acacio90/curupira-diy/3d/kicad/LEIA-ME.md

# Modelos 3D da biblioteca padrão do KiCad

Cópias dos modelos usados na placa, para o projeto abrir completo mesmo sem a
biblioteca 3D do KiCad instalada. Fonte: https://gitlab.com/kicad/libraries/kicad-packages3d

Licença: CC-BY-SA 4.0 com a exceção das bibliotecas do KiCad
(https://www.kicad.org/libraries/license/) — o uso em projetos de placa é livre.
