acacio90/curupira-diy/arte/curupira_rosto.png

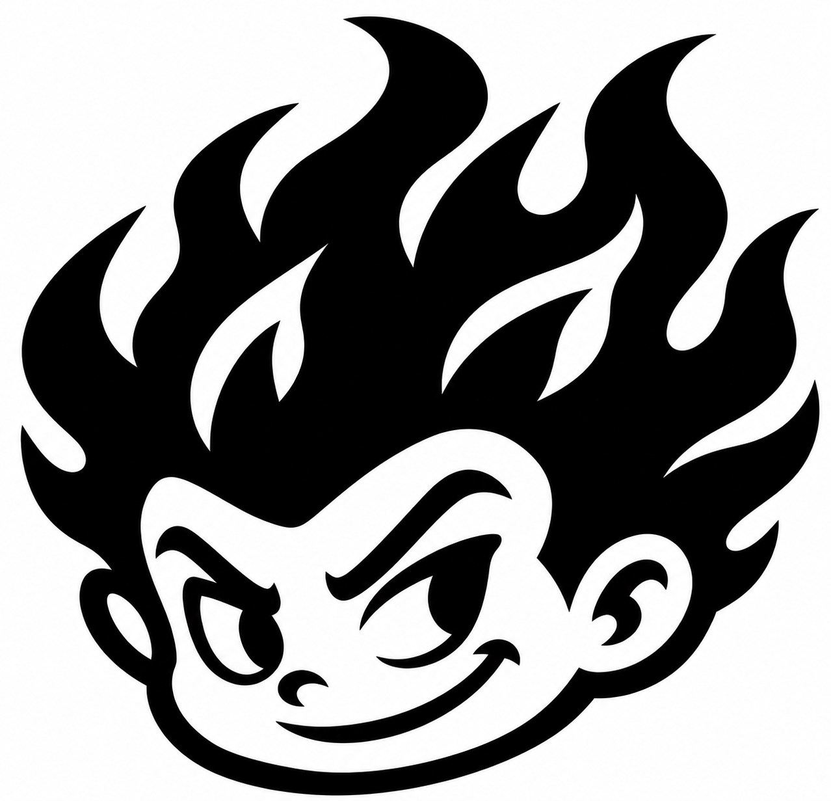
arte/curupira_rosto.png
