acacio90/curupira-diy/arte/curupira_rosto_branco.png

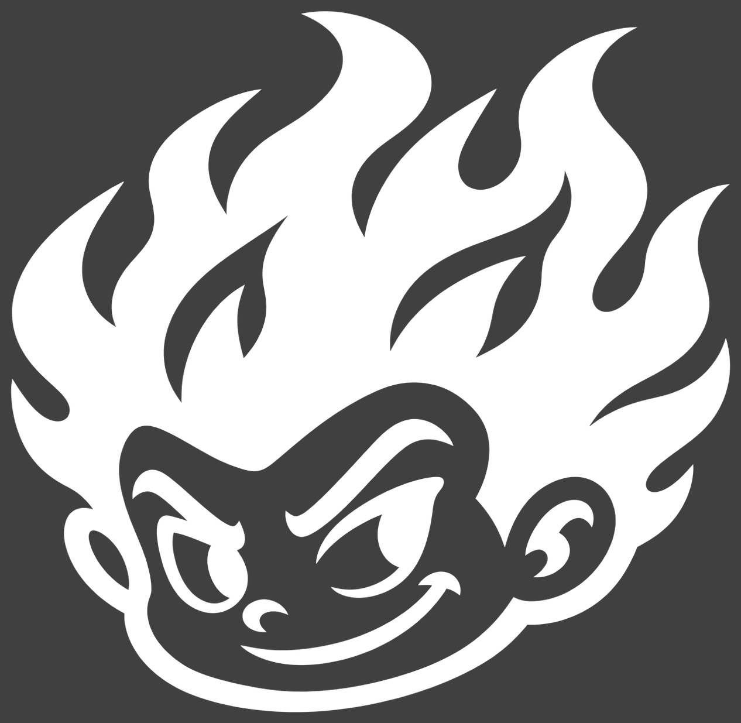
arte/curupira_rosto_branco.png
