acacio90/curupira-diy/arte/curupira_verso_pcb.png

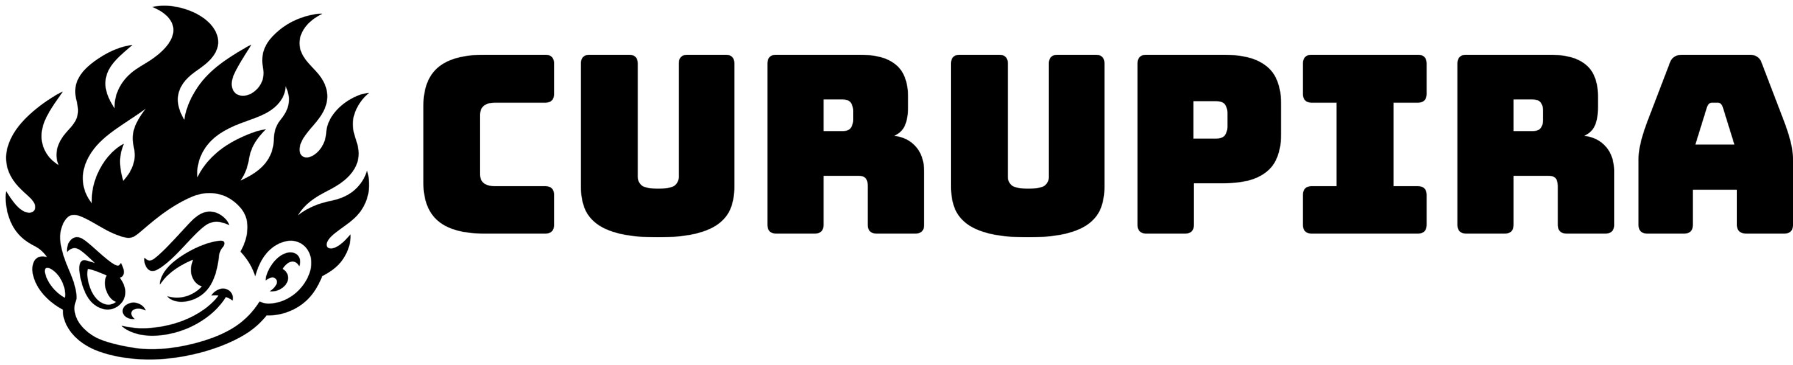
arte/curupira_verso_pcb.png
