acacio90/curupira-diy/renders/2d-frente.png

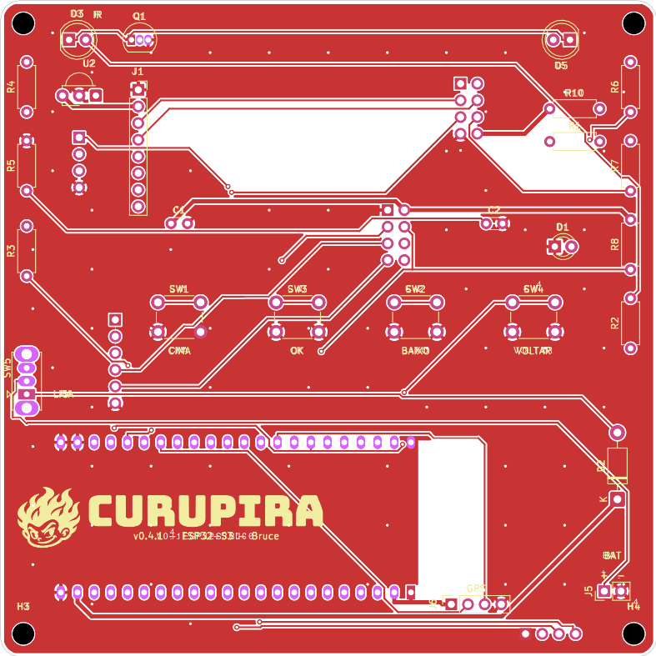
renders/2d-frente.png
