acacio90/curupira-diy/renders/2d-verso.png

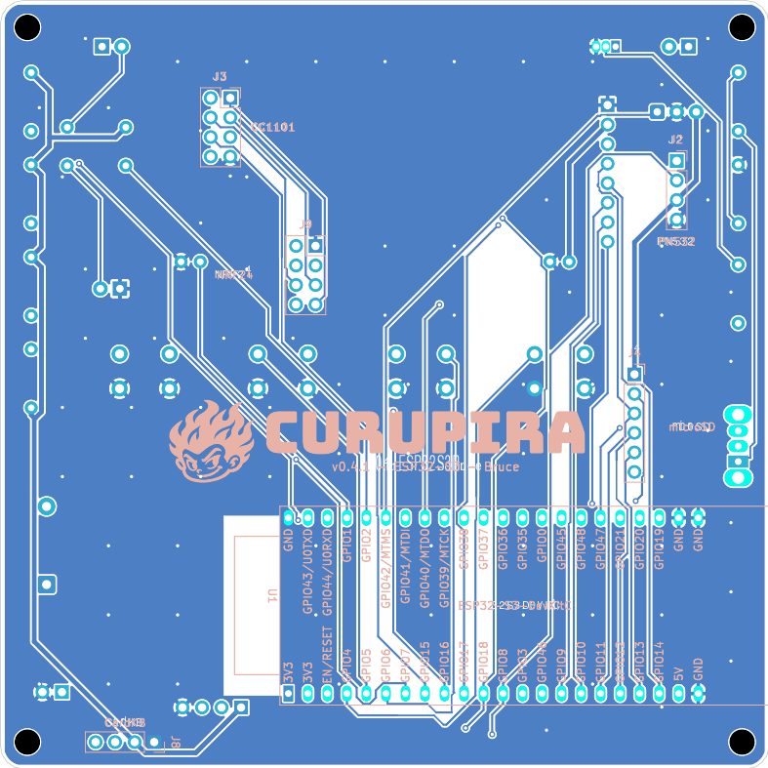
renders/2d-verso.png
