acacio90/curupira-diy/renders/3d-frente-topo.png

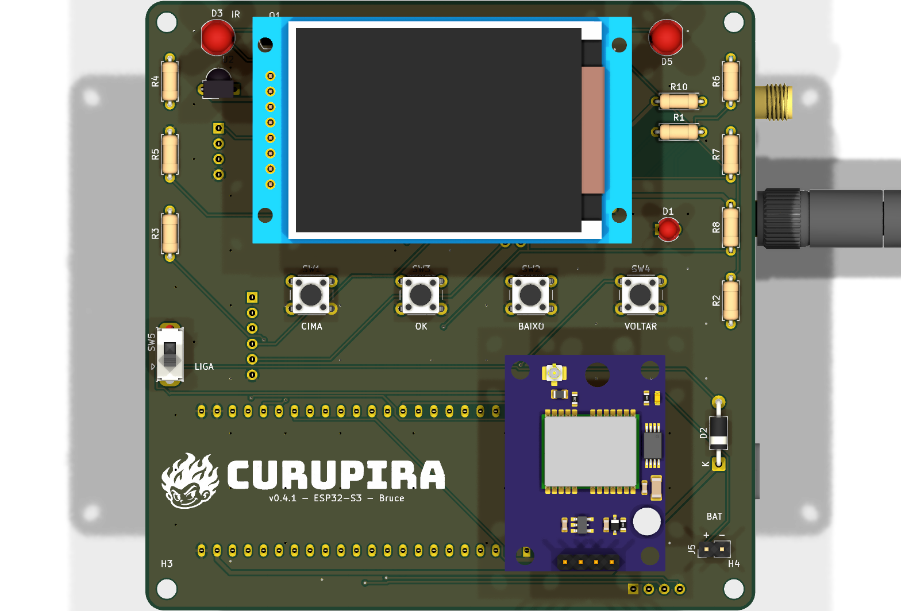
renders/3d-frente-topo.png
