acacio90/curupira-diy/renders/3d-lado-direito.png

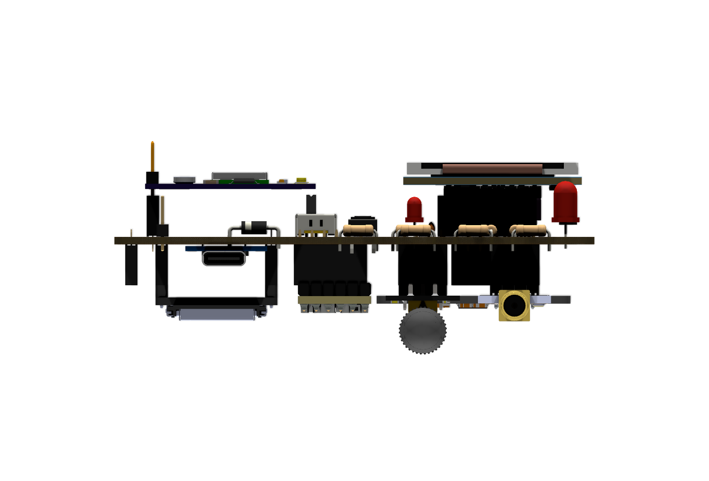
renders/3d-lado-direito.png
