acacio90/curupira-diy/renders/3d-lado-frente.png

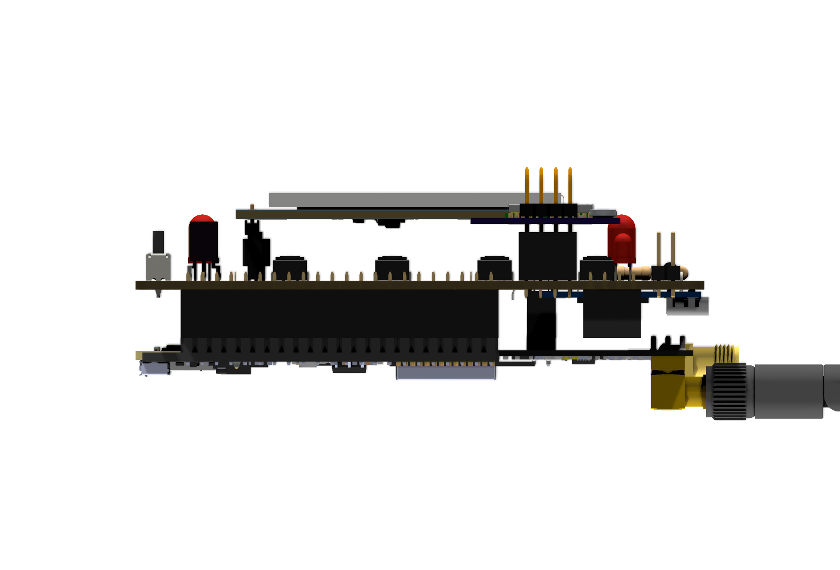
renders/3d-lado-frente.png
