acacio90/curupira-diy/renders/3d-perspectiva.png

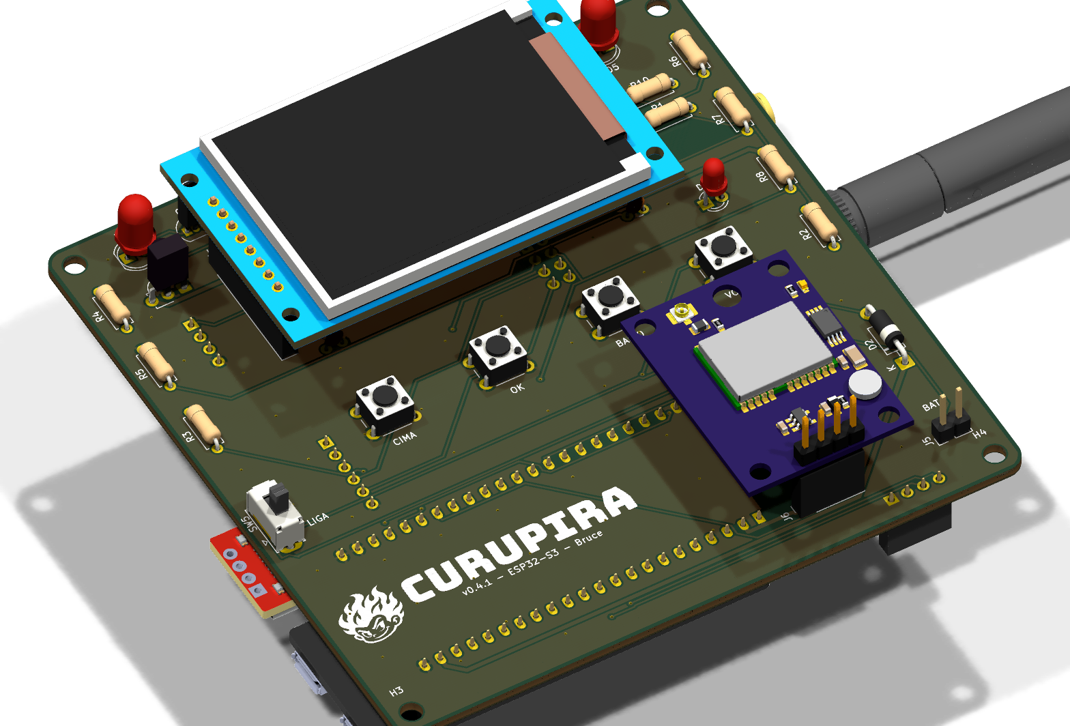
renders/3d-perspectiva.png
