acacio90/curupira-diy/renders/3d-verso-perspectiva.png

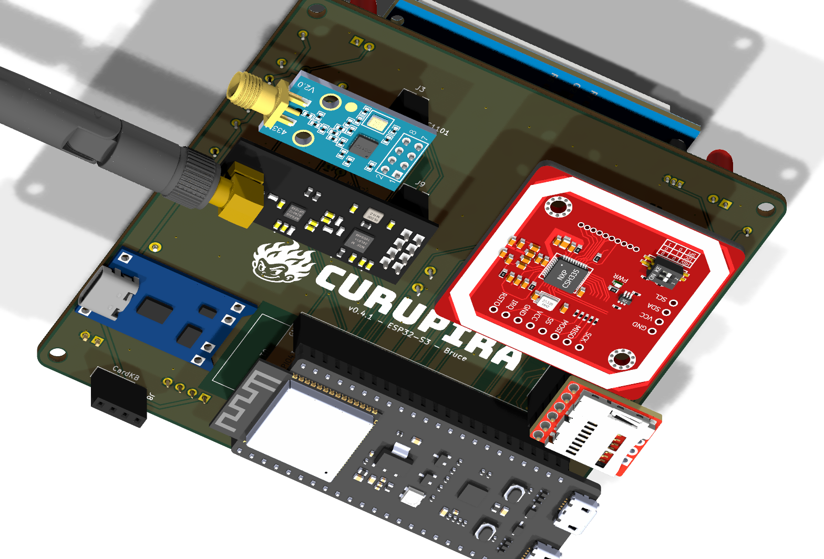
renders/3d-verso-perspectiva.png
