acacio90/curupira-diy/renders/3d-verso.png

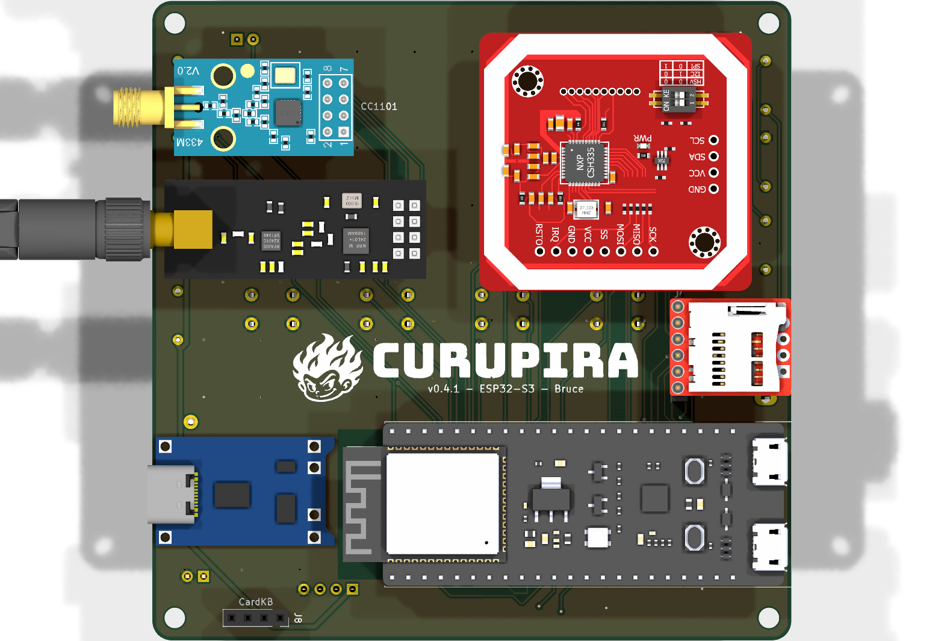
renders/3d-verso.png
