acacio90/curupira-diy/renders/esquematico.png

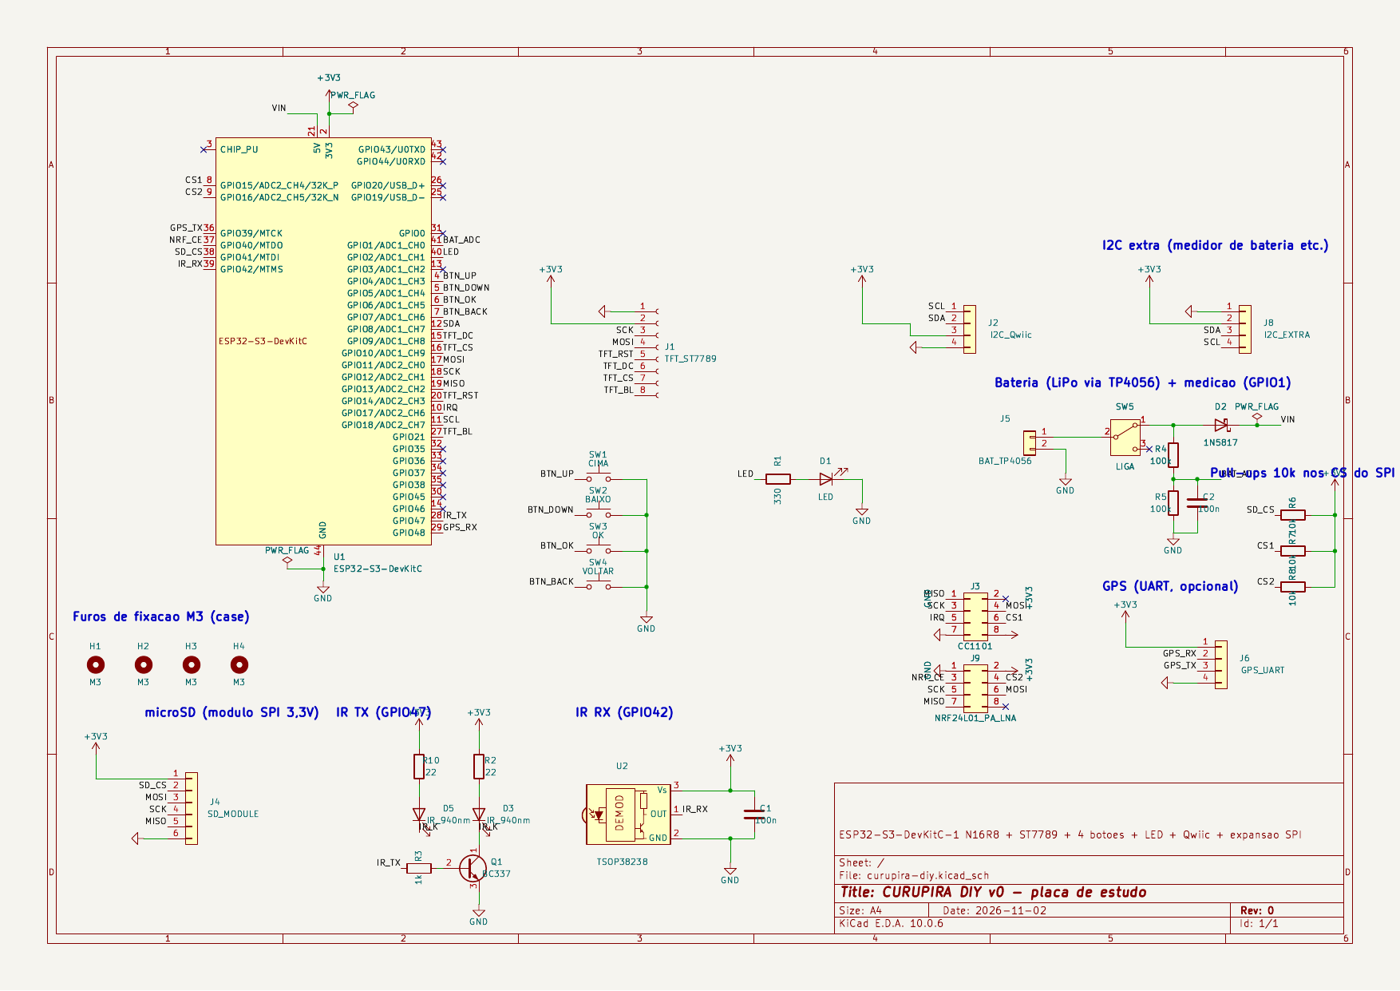
renders/esquematico.png
