acacio90/curupira-diy/production/bom.csv

Reference | Value | Footprint | QUANTITY
C1,C2 | 100n | Capacitor_THT:C_Disc_D3.0mm_W1.6mm_P2.50mm | 2
D1 | LED | LED_THT:LED_D3.0mm | 1
D2 | 1N5817 | Diode_THT:D_DO-41_SOD81_P10.16mm_Horizontal | 1
D3,D5 | IR_940nm | LED_THT:LED_D5.0mm | 2
J1 | TFT_ST7789 | Connector_PinSocket_2.54mm:PinSocket_1x08_P2.54mm_Vertical | 1
J2 | I2C_Qwiic | Connector_PinSocket_2.54mm:PinSocket_1x04_P2.54mm_Vertical | 1
J3 | CC1101 | Connector_PinSocket_2.54mm:PinSocket_2x04_P2.54mm_Vertical | 1
J4 | SD_MODULE | Connector_PinSocket_2.54mm:PinSocket_1x06_P2.54mm_Vertical | 1
J5 | BAT_TP4056 | Connector_PinHeader_2.54mm:PinHeader_1x02_P2.54mm_Vertical | 1
J6 | GPS_UART | Connector_PinSocket_2.54mm:PinSocket_1x04_P2.54mm_Vertical | 1
J8 | I2C_EXTRA | Connector_PinSocket_2.54mm:PinSocket_1x04_P2.54mm_Vertical | 1
J9 | NRF24L01_PA_LNA | Connector_PinSocket_2.54mm:PinSocket_2x04_P2.54mm_Vertical | 1
Q1 | BC337 | Package_TO_SOT_THT:TO-92_Inline | 1
R1 | 330 | Resistor_THT:R_Axial_DIN0207_L6.3mm_D2.5mm_P7.62mm_Horizontal | 1
R2,R10 | 22 | Resistor_THT:R_Axial_DIN0207_L6.3mm_D2.5mm_P7.62mm_Horizontal | 2
R3 | 1k | Resistor_THT:R_Axial_DIN0207_L6.3mm_D2.5mm_P7.62mm_Horizontal | 1
R4,R5 | 100k | Resistor_THT:R_Axial_DIN0207_L6.3mm_D2.5mm_P7.62mm_Horizontal | 2
R6-R8 | 10k | Resistor_THT:R_Axial_DIN0207_L6.3mm_D2.5mm_P7.62mm_Horizontal | 3
SW1 | CIMA | Button_Switch_THT:SW_PUSH_6mm | 1
SW2 | BAIXO | Button_Switch_THT:SW_PUSH_6mm | 1
SW3 | OK | Button_Switch_THT:SW_PUSH_6mm | 1
SW4 | VOLTAR | Button_Switch_THT:SW_PUSH_6mm | 1
SW5 | LIGA | Button_Switch_THT:SW_Slide_SPDT_Straight_CK_OS102011MS2Q | 1
U1 | ESP32-S3-DevKitC | PCM_Espressif:ESP32-S3-DevKitC | 1
U2 | TSOP38238 | OptoDevice:Vishay_MINICAST-3Pin | 1
