acacio90/curupira-diy/3d/TP4056-USB-C.step

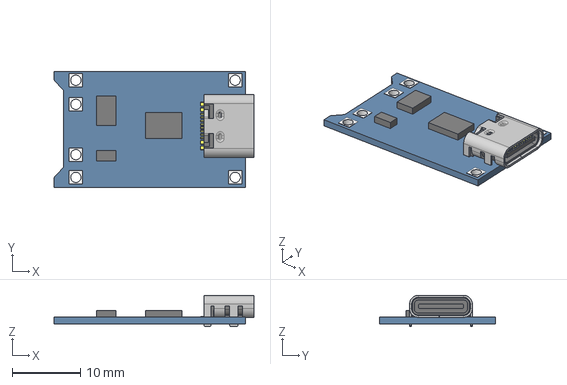
[picture p16: CAD file, 2026-11-04]
3d/TP4056-USB-C.step
29.3 x 17.0 x 4.60 mm
