acacio90/curupira-diy/3d/kicad/D_DO-41_SOD81_P10.16mm_Horizontal.step

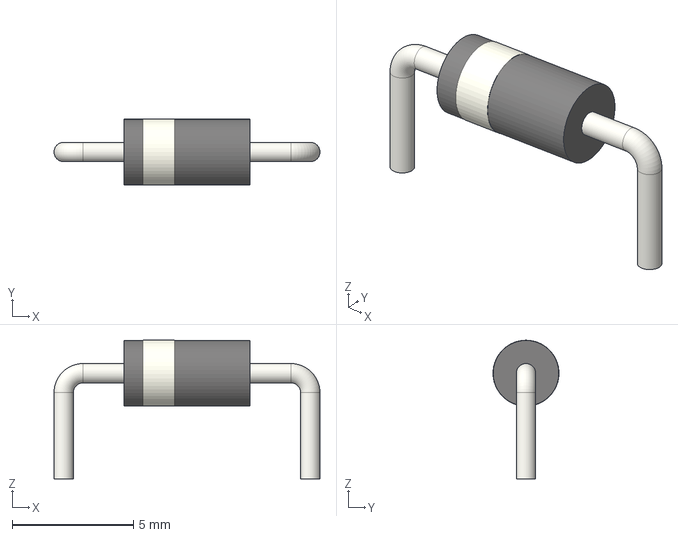
[picture p17: CAD file, 2026-11-04]
3d/kicad/D_DO-41_SOD81_P10.16mm_Horizontal.step
11.0 x 2.72 x 5.71 mm
