acacio90/curupira-diy/3d/TFT-ST7789-2.0-GMT020-02.step

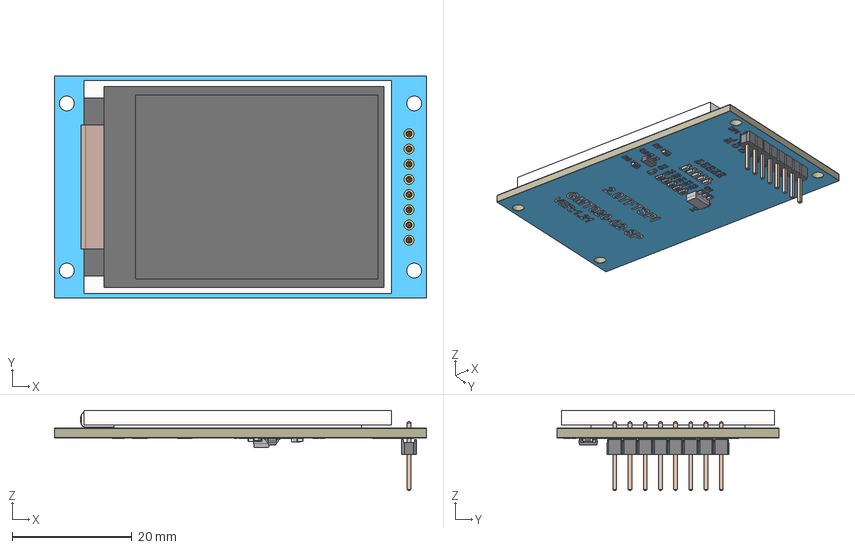
[picture p18: CAD file, 2026-11-04]
3d/TFT-ST7789-2.0-GMT020-02.step
62.2 x 37.2 x 13.4 mm
Board
64-copper
1-soldermask
64-soldermask
6130xx11121_PIN x 8
SOT23
DIODE_PGB-0603MP x 5
5576557.f3d x 7
CAP_0603 x 2
SOT89
1-copper
Text
Screen support
Ribon cable
Glass
