acacio90/curupira-diy/3d/microSD-substituto-OpenLog.step

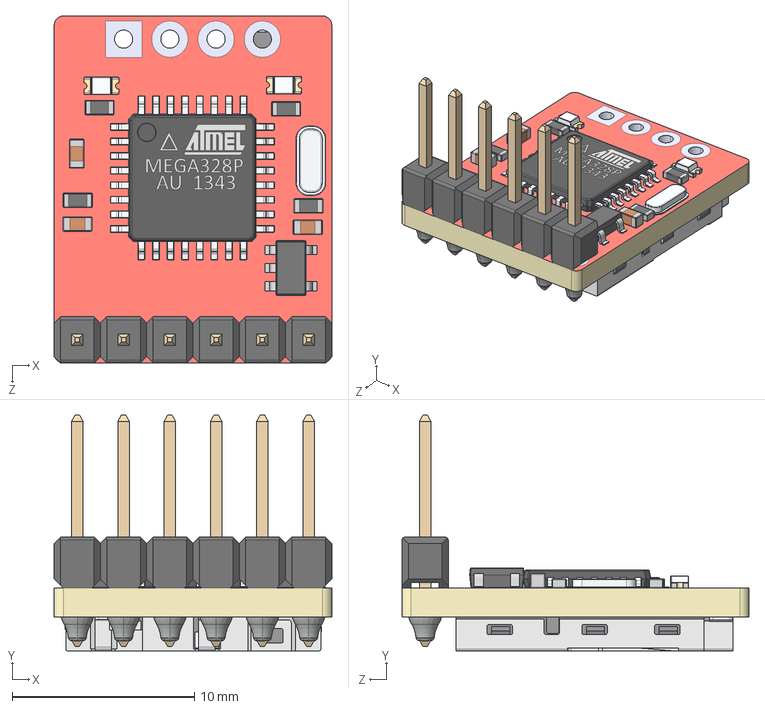
[picture p20: CAD file, 2026-11-04]
3d/microSD-substituto-OpenLog.step
15.2 x 12.9 x 19.1 mm
