acacio90/curupira-diy/3d/kicad/TO-92_Inline.step

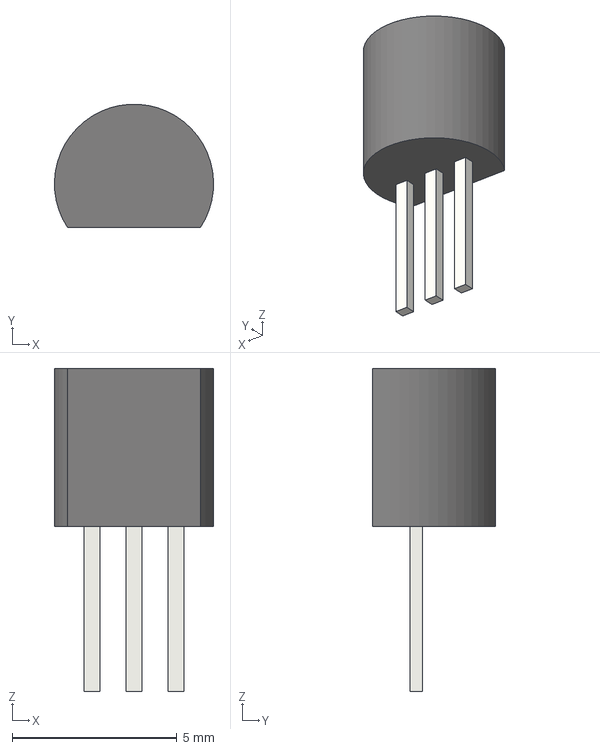
[picture p21: CAD file, 2026-11-04]
3d/kicad/TO-92_Inline.step
4.83 x 3.74 x 9.80 mm
