acacio90/curupira-diy/3d/PN532-V3.step

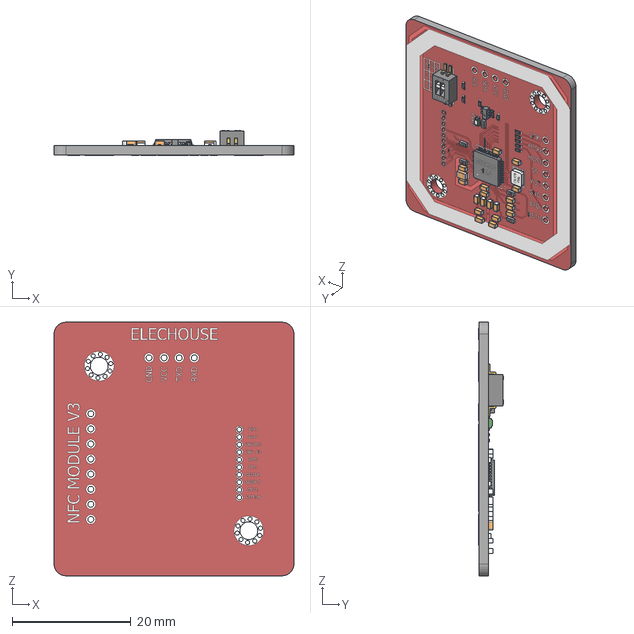
[picture p22: CAD file, 2026-11-04]
3d/PN532-V3.step
40.4 x 4.13 x 42.7 mm
