acacio90/curupira-diy/3d/CC1101-E07-M1101D-SMA.step

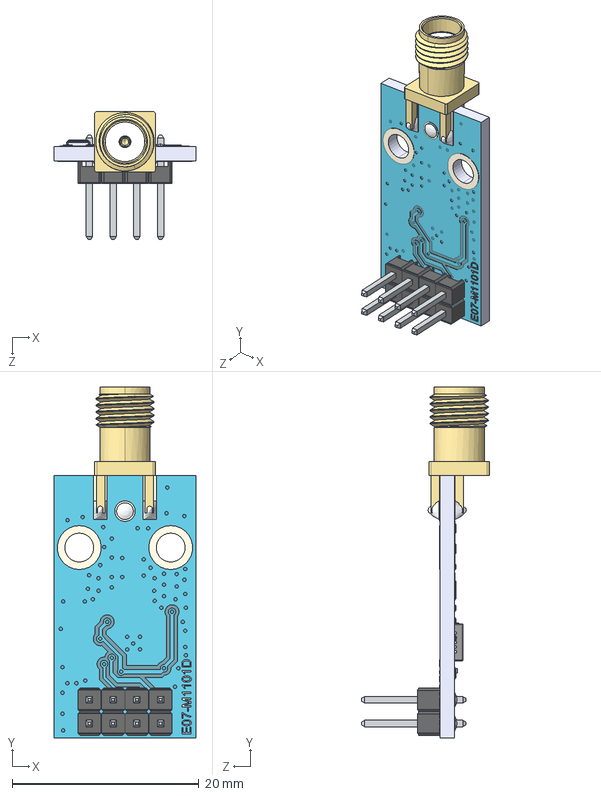
[picture p23: CAD file, 2026-11-04]
3d/CC1101-E07-M1101D-SMA.step
15.2 x 37.6 x 13.7 mm
CC1101 PCB_2xconf_PCB_SMA
100mill Male Pin Header_2P_Bk x 4
3225 SMD Crystal Oscillator
QFN-20 (4x4x0.9)
RES0402 x 17
Dielectric
Pin
