acacio90/curupira-diy/3d/kicad/LED_D5.0mm.step

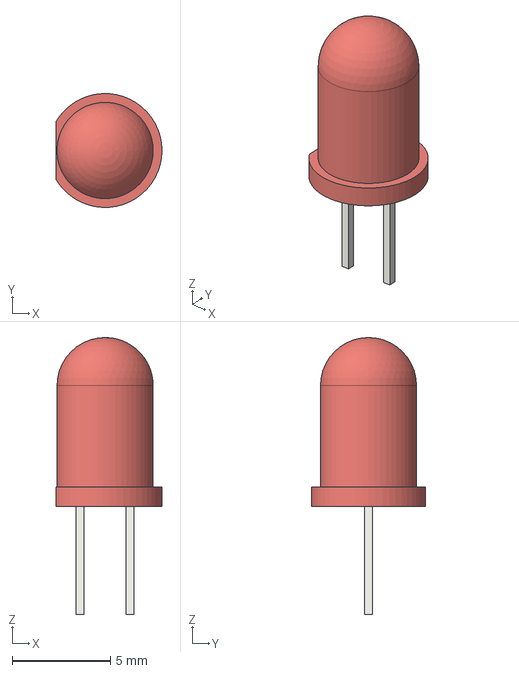
[picture p24: CAD file, 2026-11-04]
3d/kicad/LED_D5.0mm.step
5.40 x 5.79 x 14.1 mm
