acacio90/curupira-diy/3d/GPS-NEO-6M.step

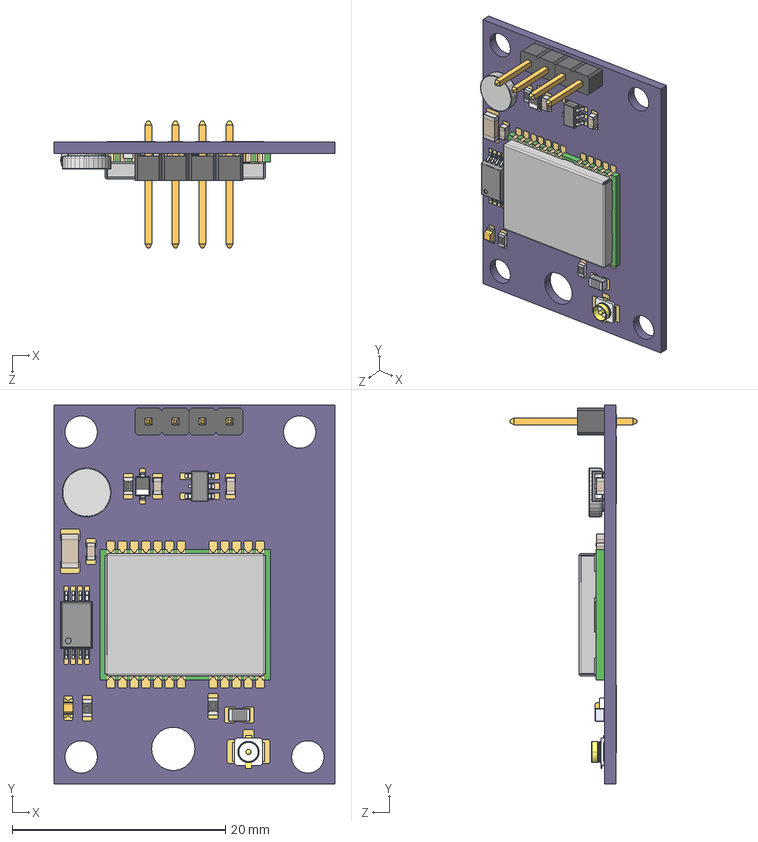
[picture p25: CAD file, 2026-11-04]
3d/GPS-NEO-6M.step
26.3 x 35.6 x 11.9 mm
NEO-6M_v100
NEO-6M_v100-bottom
NEO-6M_v100-top
