acacio90/curupira-diy/3d/kicad/PinSocket_1x04_P2.54mm_Vertical.step

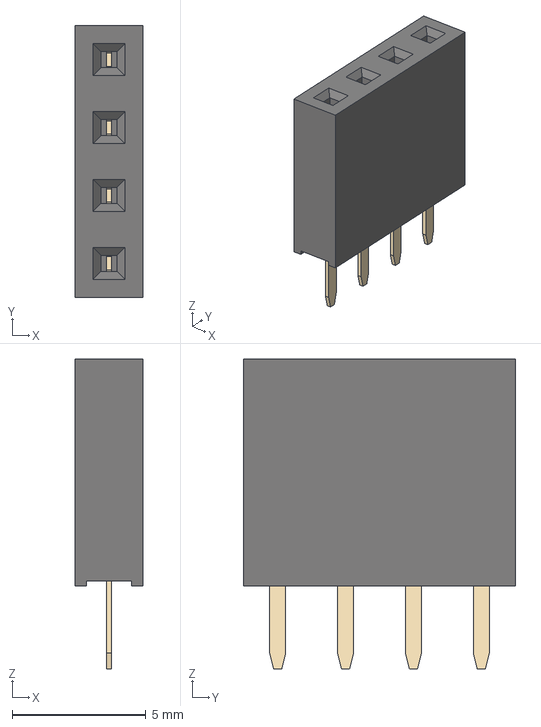
[picture p26: CAD file, 2026-11-04]
3d/kicad/PinSocket_1x04_P2.54mm_Vertical.step
2.54 x 10.2 x 11.6 mm
