acacio90/curupira-diy/3d/kicad/C_Disc_D3.0mm_W1.6mm_P2.50mm.step

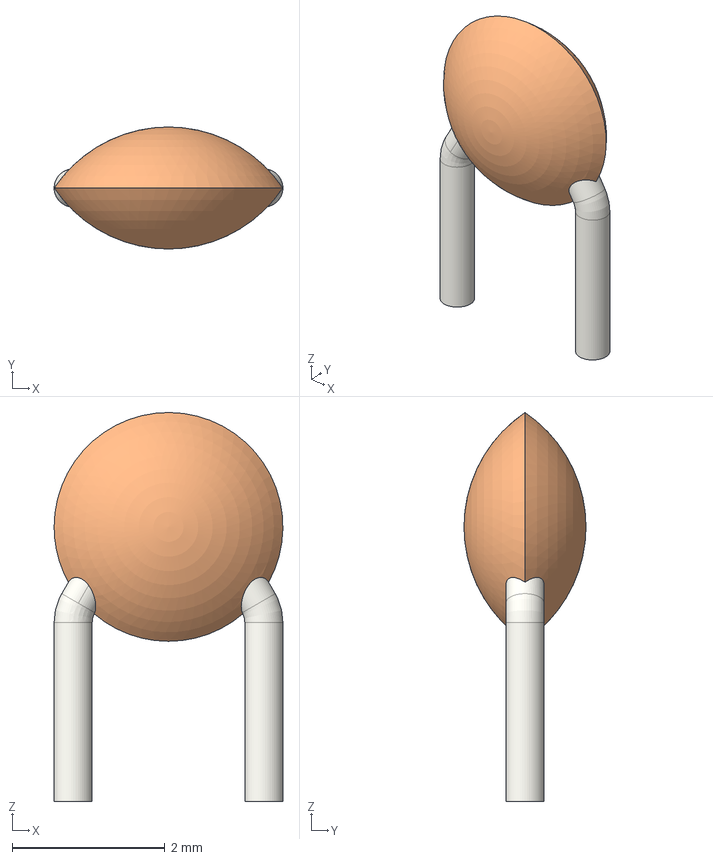
[picture p27: CAD file, 2026-11-04]
3d/kicad/C_Disc_D3.0mm_W1.6mm_P2.50mm.step
3.00 x 1.60 x 5.10 mm
