acacio90/curupira-diy/3d/NRF24L01-PA-LNA.step

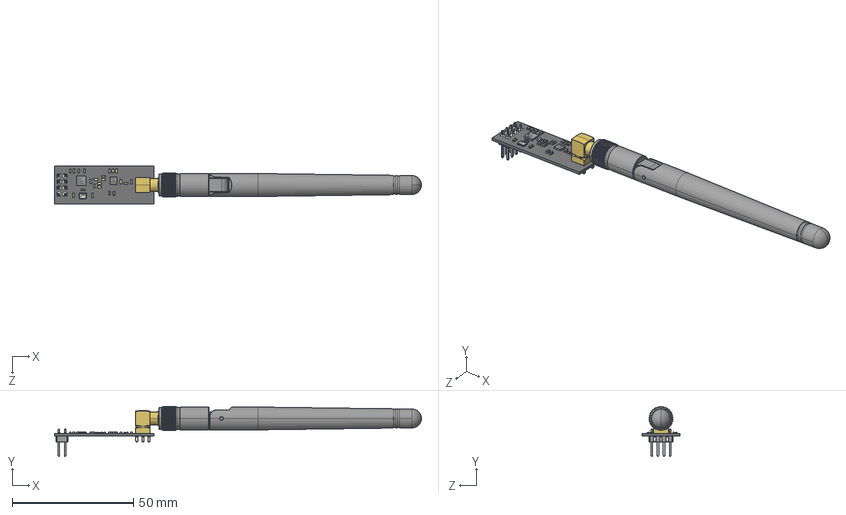
[picture p28: CAD file, 2026-11-04]
3d/NRF24L01-PA-LNA.step
151.4 x 20.7 x 15.5 mm
NRF24L01L
Antenna base
Antenna top
