acacio90/curupira-diy/3d/ESP32-S3-DevKitC-1.step

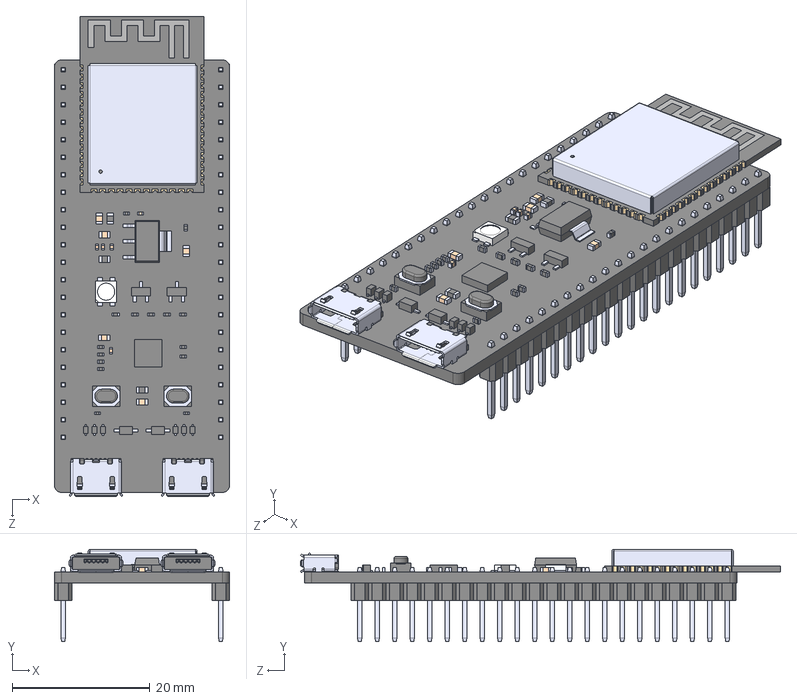
[picture p29: CAD file, 2026-11-04]
3d/ESP32-S3-DevKitC-1.step
25.4 x 13.4 x 69.6 mm
