acacio90/curupira-diy/3d/kicad/PinHeader_1x02_P2.54mm_Vertical.step

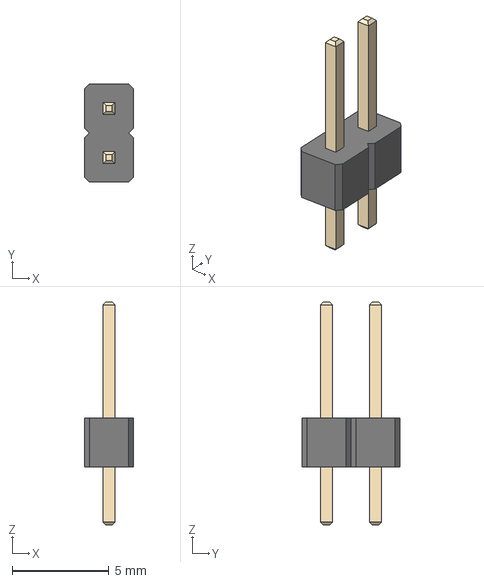
[picture p30: CAD file, 2026-11-04]
3d/kicad/PinHeader_1x02_P2.54mm_Vertical.step
2.54 x 5.08 x 11.5 mm
