acacio90/curupira-diy/3d/kicad/Vishay_MINICAST-3Pin.step

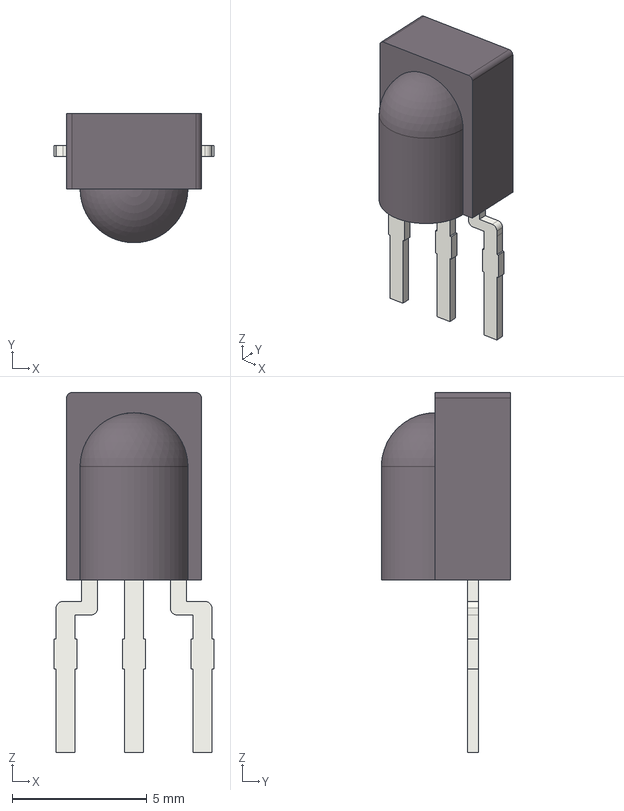
[picture p31: CAD file, 2026-11-04]
3d/kicad/Vishay_MINICAST-3Pin.step
5.93 x 4.80 x 13.3 mm
