acacio90/curupira-diy/3d/kicad/SW_Slide_SPDT_Straight_CK_OS102011MS2Q.step

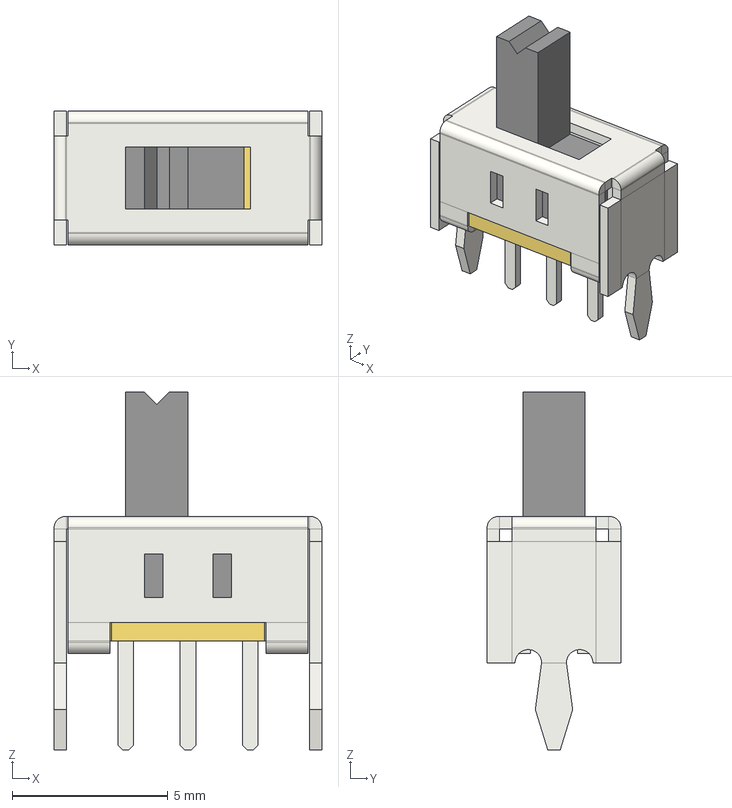
[picture p33: CAD file, 2026-11-04]
3d/kicad/SW_Slide_SPDT_Straight_CK_OS102011MS2Q.step
8.60 x 4.30 x 11.5 mm
