acacio90/curupira-diy/3d/kicad/D_DO-35_SOD27_P7.62mm_Horizontal.step

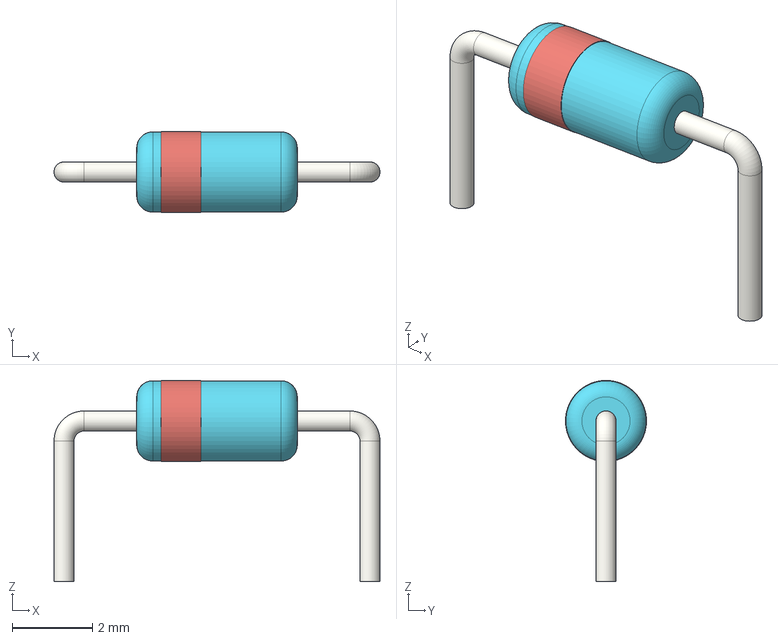
[picture p34: CAD file, 2026-11-04]
3d/kicad/D_DO-35_SOD27_P7.62mm_Horizontal.step
8.12 x 2.02 x 5.01 mm
