acacio90/curupira-diy/3d/kicad/SW_PUSH_6mm.step

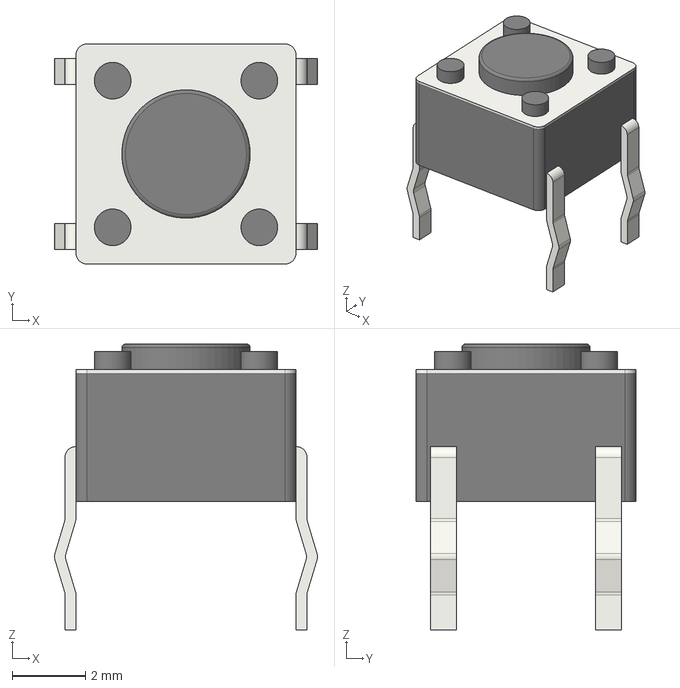
[picture p35: CAD file, 2026-11-04]
3d/kicad/SW_PUSH_6mm.step
7.17 x 6.00 x 7.80 mm
