acacio90/curupira-diy/3d/kicad/LED_D3.0mm.step

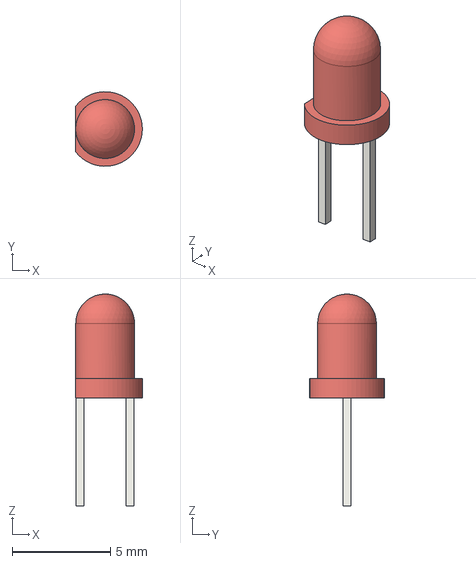
[picture p36: CAD file, 2026-11-04]
3d/kicad/LED_D3.0mm.step
3.40 x 3.80 x 10.8 mm
