acacio90/curupira-diy/3d/kicad/Buzzer_12x9.5RM7.6.step

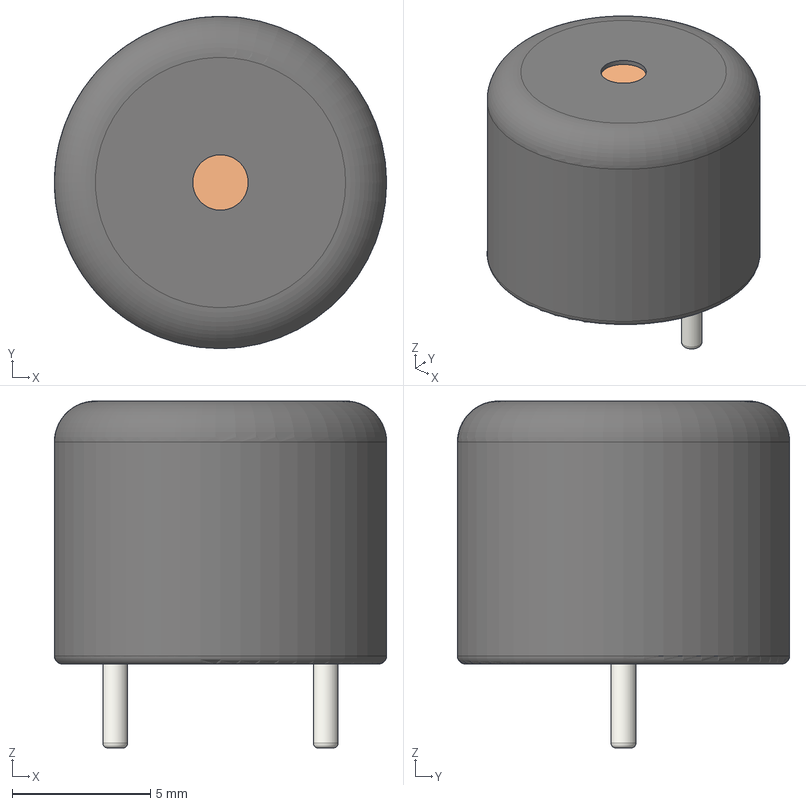
[picture p39: CAD file, 2026-11-04]
3d/kicad/Buzzer_12x9.5RM7.6.step
12.0 x 12.0 x 12.5 mm
