acacio90/curupira-diy/docs/teste-protoboard.html

CURUPIRA v0.4.1 · manual de bancada

# Teste na protoboard, passo a passo

Cada passo coloca um bloco do circuito na protoboard. Monte, rode o teste, marque o que passou e só então avance. Os blocos anteriores ficam montados: no final está tudo ligado junto, como na placa.

Tema: automático

mostrar o que já foi montado

Desenho esquemático, fora de escala. Os módulos (tela, SD, rádios, NFC, teclado, GPS, carregador) ficam fora da protoboard, ligados por jumpers macho-fêmea. Passe o mouse num fio ou peça para ver o que ele liga.
