acacio90/curupira-diy/renders/esquematico.pdf

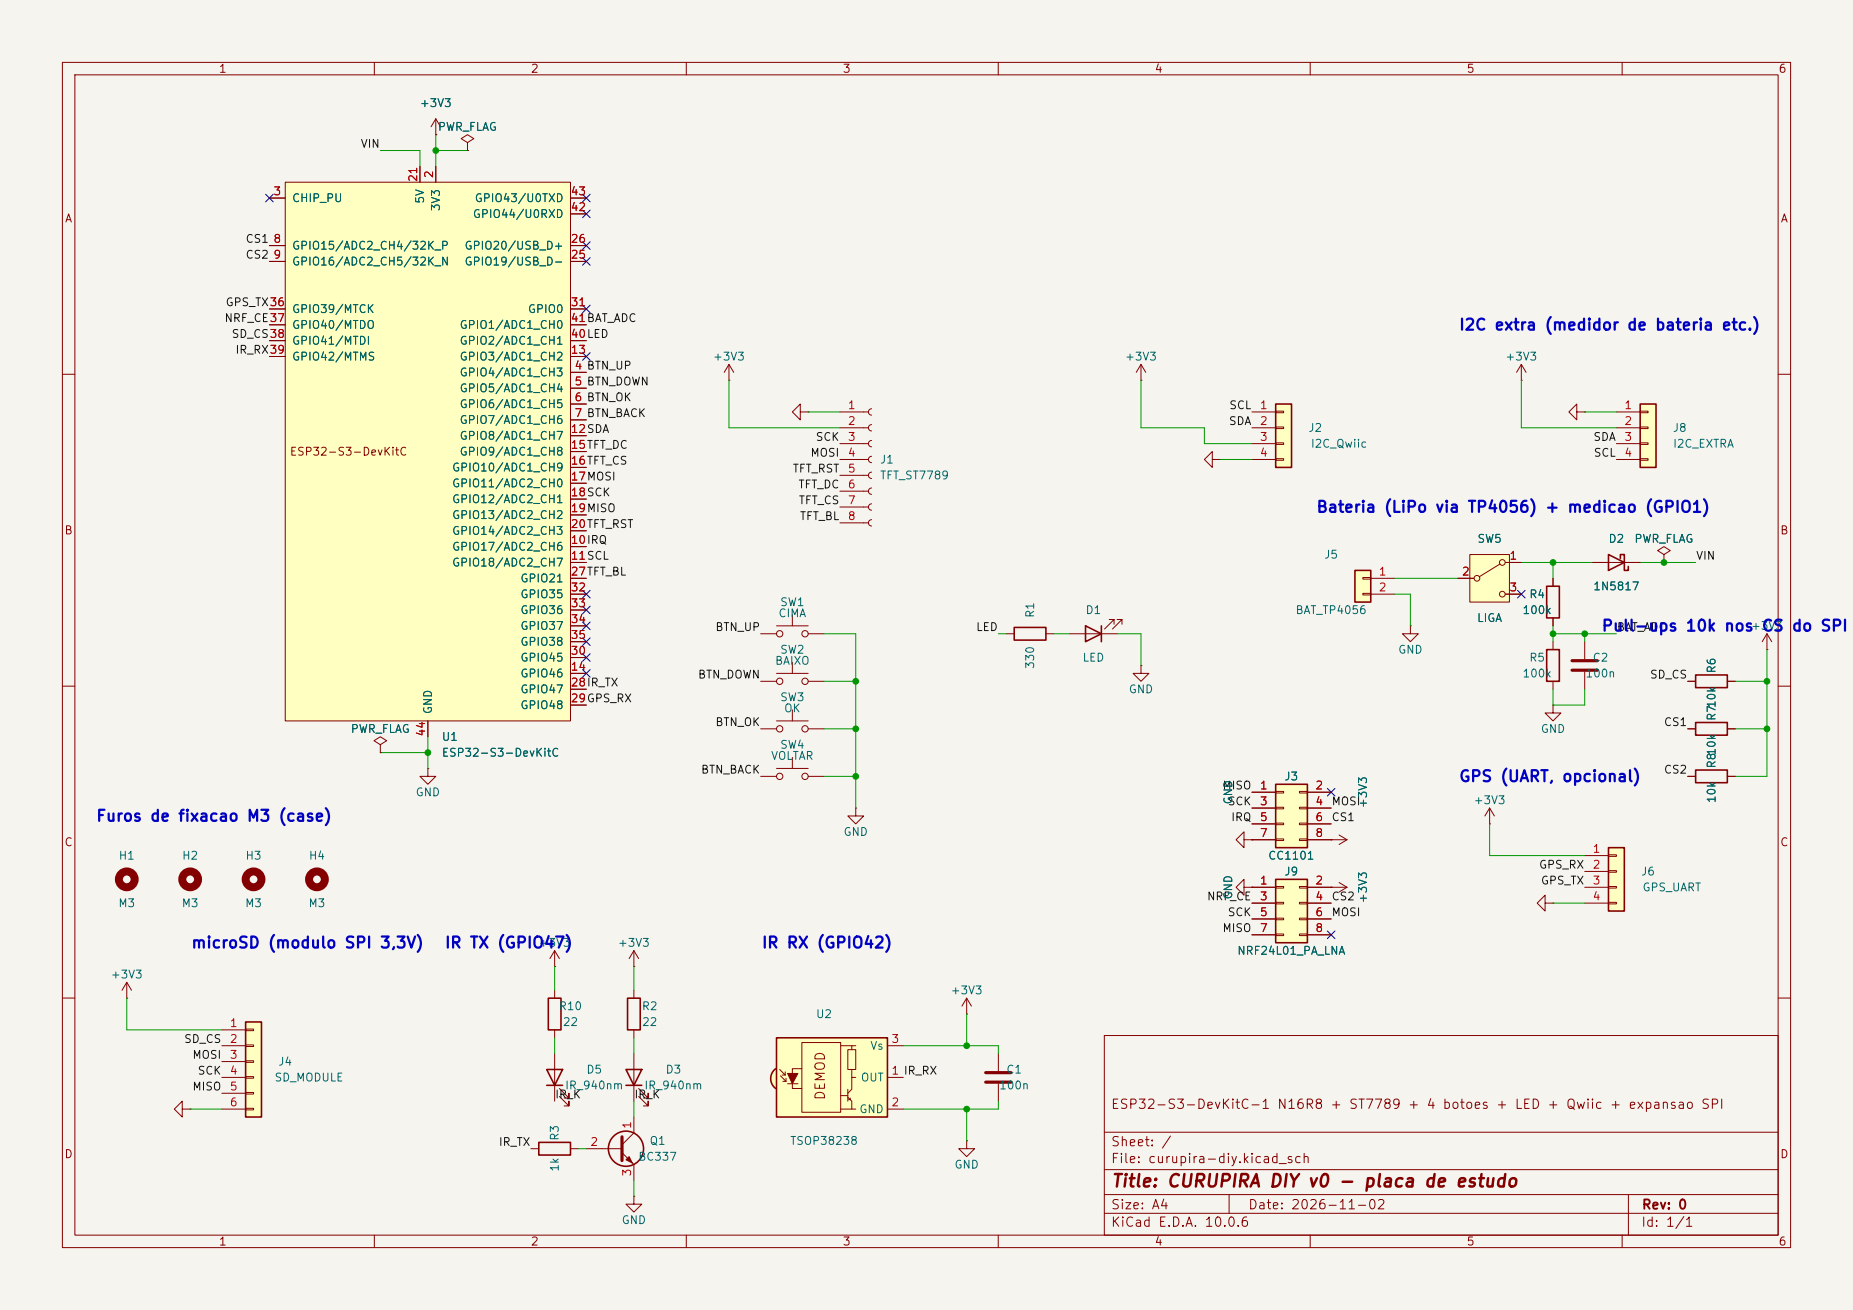
[picture p40: page 1]

Bateria (LiPo via TP4056) + medicao (GPIO1) +3V3PWR_FLAG U1

I2C extra (medidor de bateria etc.)

Pull-ups 10k nos CS do SPI

Furos de fixacao M3 (case)

ESP32-S3-DevKitC-1 N16R8 + ST7789 + 4 botoes + LED + Qwiic + expansao SPI

Sheet: /
File: curupira-diy.kicad_sch
Title: CURUPIRA DIY v0 - placa de estudo

Size: A4 | Rev: 0
KiCad E.D.A. 10.0.6 | Id: 1/1
