acacio90/curupira-diy/curupira-diy.kicad_pcb

## KiCad design curupira-diy.kicad_pcb (2026-11-05)

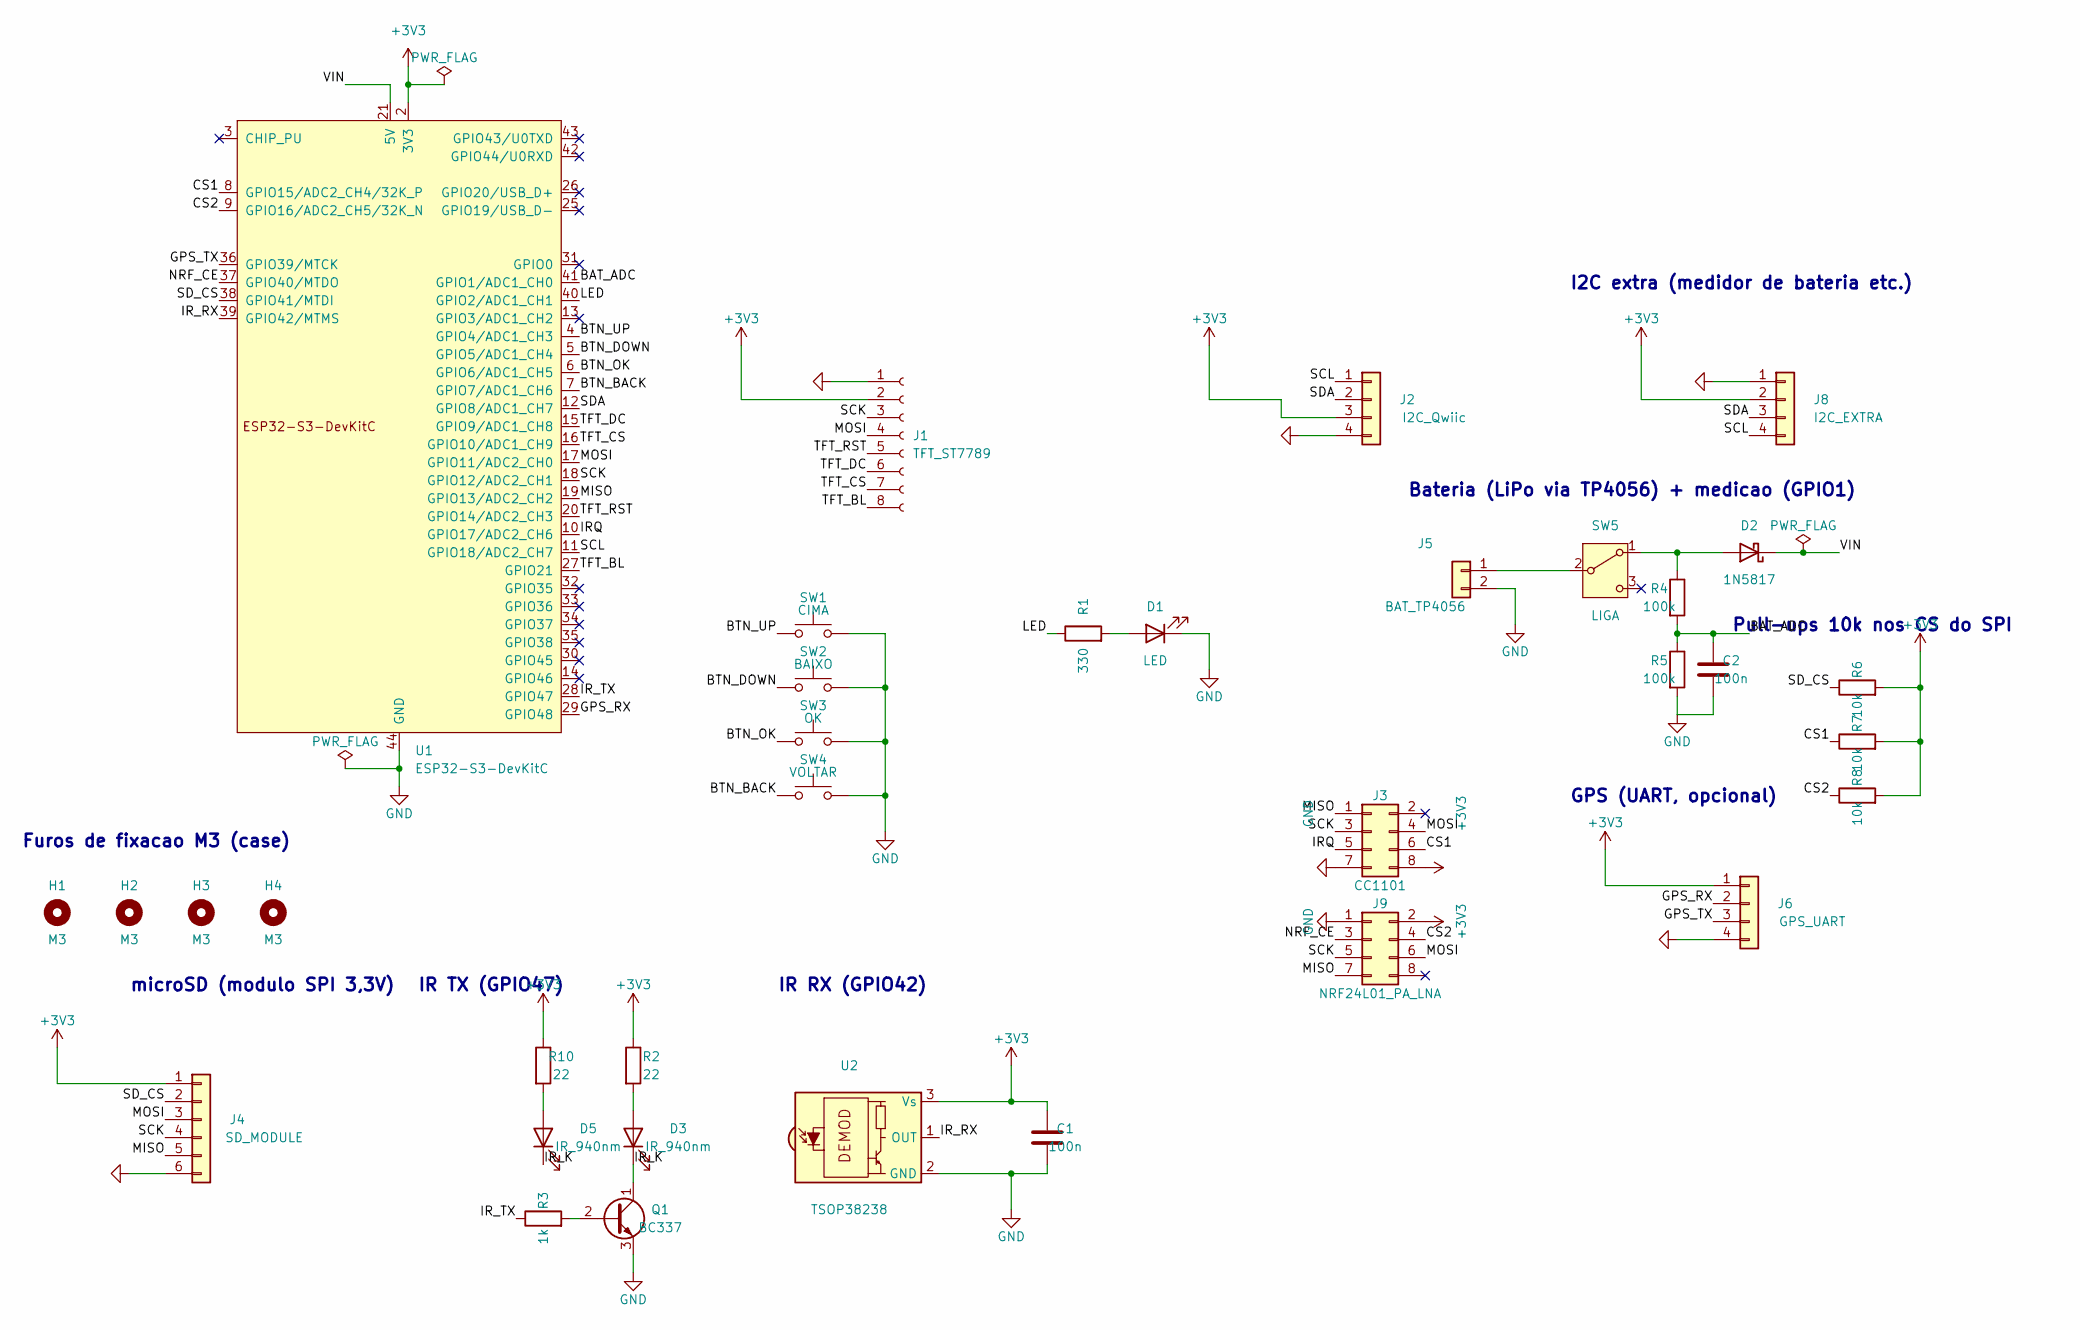
[picture p41: schematic curupira-diy.kicad_sch, CURUPIRA DIY v0 - placa de estudo]

Parts:
C1, C2: 100n; C_Disc_D3.0mm_W1.6mm_P2.50mm
D1: LED; LED_D3.0mm
D2: 1N5817; D_DO-41_SOD81_P10.16mm_Horizontal
D3, D5: IR_940nm; LED_D5.0mm
H1, H2, H3, H4: M3; MountingHole_3.2mm_M3
J1: TFT_ST7789; PinSocket_1x08_P2.54mm_Vertical
J2: I2C_Qwiic; PinSocket_1x04_P2.54mm_Vertical
J3: CC1101; PinSocket_2x04_P2.54mm_Vertical
J4: SD_MODULE; PinSocket_1x06_P2.54mm_Vertical
J5: BAT_TP4056; PinHeader_1x02_P2.54mm_Vertical
J6: GPS_UART; PinSocket_1x04_P2.54mm_Vertical
J8: I2C_EXTRA; PinSocket_1x04_P2.54mm_Vertical
J9: NRF24L01_PA_LNA; PinSocket_2x04_P2.54mm_Vertical
Q1: BC337; TO-92_Inline
R1: 330; R_Axial_DIN0207_L6.3mm_D2.5mm_P7.62mm_Horizontal
R2, R10: 22; R_Axial_DIN0207_L6.3mm_D2.5mm_P7.62mm_Horizontal
R3: 1k; R_Axial_DIN0207_L6.3mm_D2.5mm_P7.62mm_Horizontal
R4, R5: 100k; R_Axial_DIN0207_L6.3mm_D2.5mm_P7.62mm_Horizontal
R6, R7, R8: 10k; R_Axial_DIN0207_L6.3mm_D2.5mm_P7.62mm_Horizontal
SW1: CIMA; SW_PUSH_6mm
SW2: BAIXO; SW_PUSH_6mm
SW3: OK; SW_PUSH_6mm
SW4: VOLTAR; SW_PUSH_6mm
SW5: LIGA; SW_Slide_SPDT_Straight_CK_OS102011MS2Q
U1: ESP32-S3-DevKitC
U2: TSOP38238; Vishay_MINICAST-3Pin

Connections:
+3V3: C1.1, J1.2, J2.3, J3.8, J4.1, J6.1, J8.2, J9.2, R2.1, R6.2, R7.2, R8.2, R10.1, U1.1 (3V3), U1.2 (3V3), U2.3 (Vs)
/BAT_ADC: C2.1, R4.2, R5.1, U1.41 (GPIO1/ADC1_CH0)
/BTN_BACK: SW4.1, U1.7 (GPIO7/ADC1_CH6)
/BTN_DOWN: SW2.1, U1.5 (GPIO5/ADC1_CH4)
/BTN_OK: SW3.1, U1.6 (GPIO6/ADC1_CH5)
/BTN_UP: SW1.1, U1.4 (GPIO4/ADC1_CH3)
/CS1: J3.6, R7.1, U1.8 (GPIO15/ADC2_CH4/32K_P)
/CS2: J9.4, R8.1, U1.9 (GPIO16/ADC2_CH5/32K_N)
/GPS_RX: J6.2, U1.29 (GPIO48)
/GPS_TX: J6.3, U1.36 (GPIO39/MTCK)
/IRQ: J3.5, U1.10 (GPIO17/ADC2_CH6)
/IR_K: D3.1 (K), D5.1 (K), Q1.1 (C)
/IR_RX: U1.39 (GPIO42/MTMS), U2.1 (OUT)
/IR_TX: R3.1, U1.28 (GPIO47)
/LED: R1.1, U1.40 (GPIO2/ADC1_CH1)
/MISO: J3.1, J4.5, J9.7, U1.19 (GPIO13/ADC2_CH2)
/MOSI: J1.4, J3.4, J4.3, J9.6, U1.17 (GPIO11/ADC2_CH0)
/NRF_CE: J9.3, U1.37 (GPIO40/MTDO)
/SCK: J1.3, J3.3, J4.4, J9.5, U1.18 (GPIO12/ADC2_CH1)
/SCL: J2.1, J8.4, U1.11 (GPIO18/ADC2_CH7)
/SDA: J2.2, J8.3, U1.12 (GPIO8/ADC1_CH7)
/SD_CS: J4.2, R6.1, U1.38 (GPIO41/MTDI)
/TFT_BL: J1.8, U1.27 (GPIO21)
/TFT_CS: J1.7, U1.16 (GPIO10/ADC1_CH9)
/TFT_DC: J1.6, U1.15 (GPIO9/ADC1_CH8)
/TFT_RST: J1.5, U1.20 (GPIO14/ADC2_CH3)
/VIN: D2.1 (K), U1.21 (5V)
GND: C1.2, C2.2, D1.1 (K), J1.1, J2.4, J3.7, J4.6, J5.2, J6.4, J8.1, J9.1, Q1.3 (E), R5.2, SW1.2, SW2.2, SW3.2, SW4.2, U1.22 (GND), U1.23 (GND), U1.24 (GND), U1.44 (GND), U2.2 (GND)
unnamed: D1.2 (A), R1.2
unnamed: D2.2 (A), R4.1, SW5.1 (A)
unnamed: D3.2 (A), R2.2
unnamed: D5.2 (A), R10.2
unnamed: J5.1, SW5.2 (B)
unnamed: Q1.2 (B), R3.2

Notes on the sheet:
microSD (modulo SPI 3,3V)
IR TX (GPIO47)
IR RX (GPIO42)
Bateria (LiPo via TP4056) + medicao (GPIO1)
GPS (UART, opcional)
I2C extra (medidor de bateria etc.)
Furos de fixacao M3 (case)
Pull-ups 10k nos CS do SPI

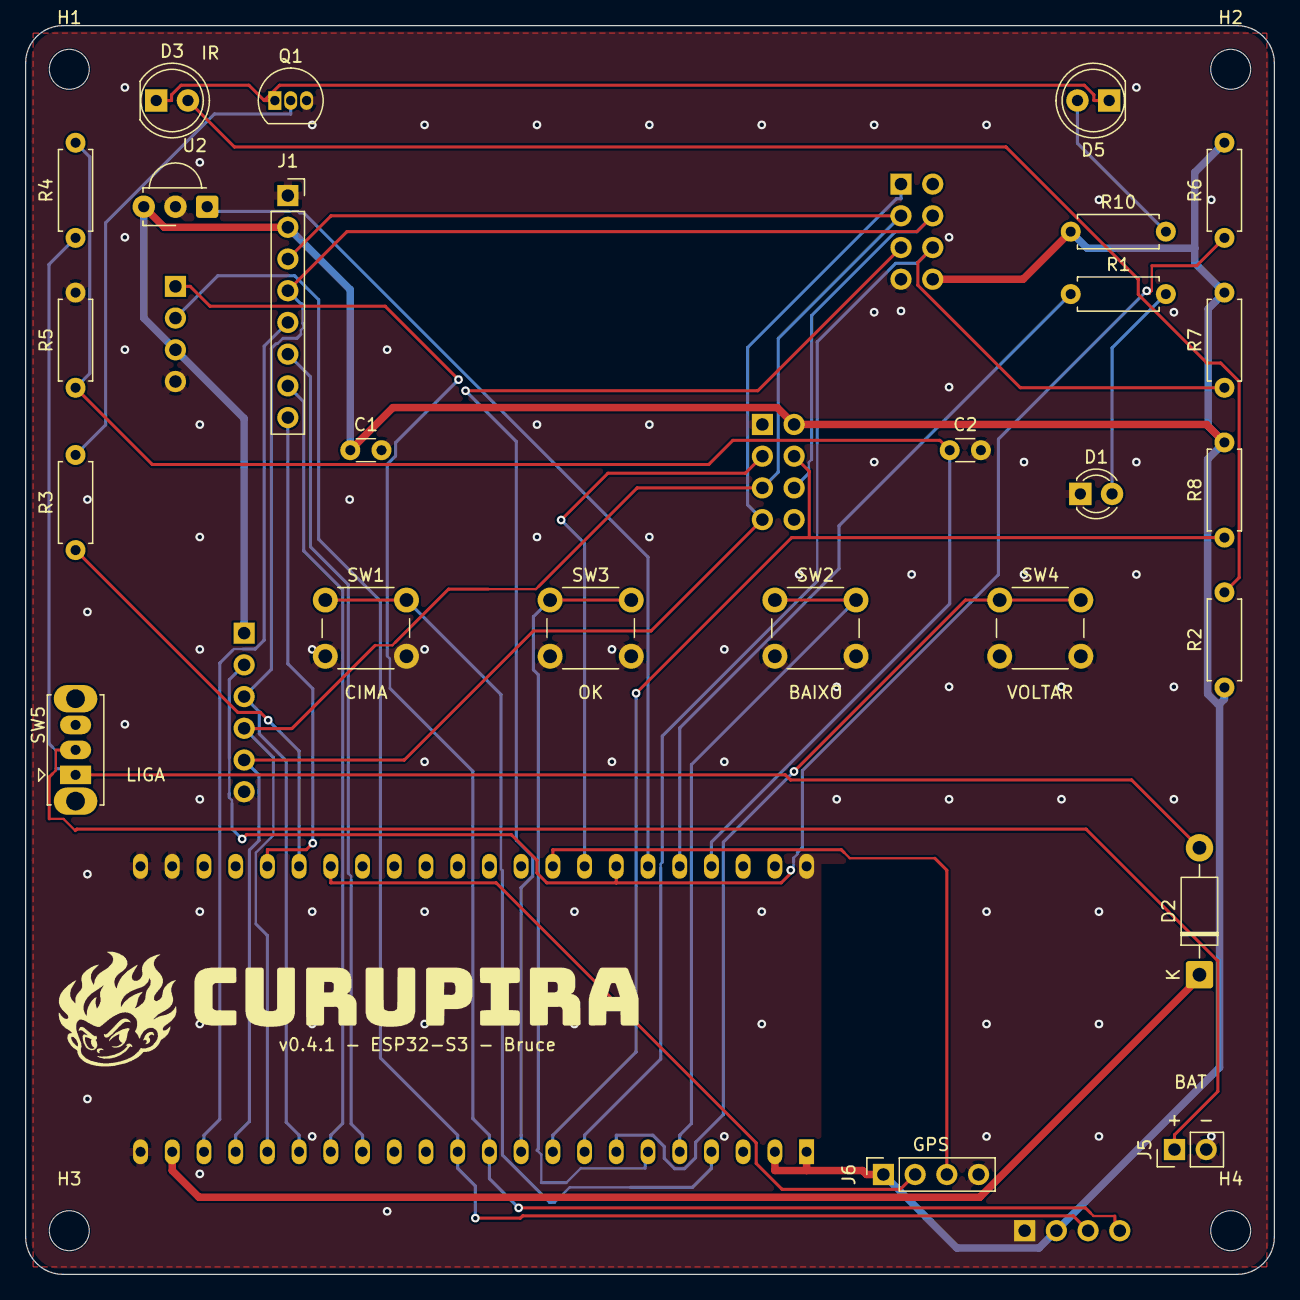
[picture p42: board curupira-diy.kicad_pcb from above]

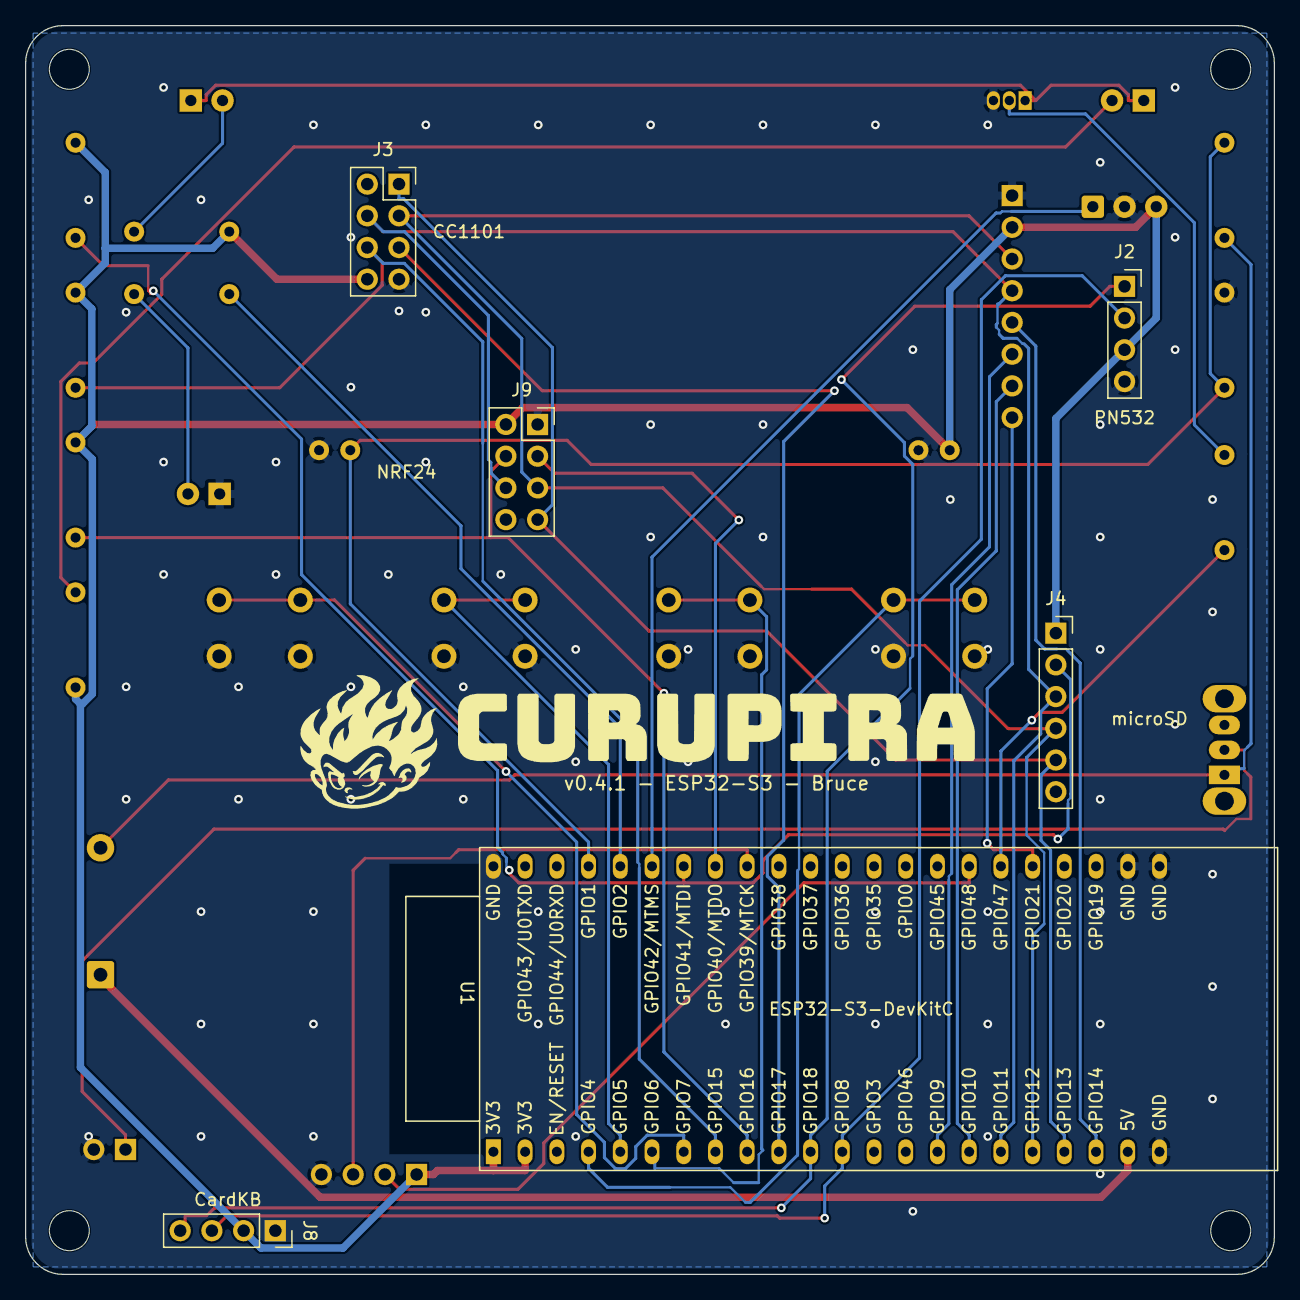
[picture p43: board curupira-diy.kicad_pcb from below]

Board: 2 copper layers, 100.0 x 100.0 mm, 35 parts (6 on the bottom side), 34 nets.
