acacio90/curupira-diy/(commit log)

2026-11-04 feat: projeto inicial CURUPIRA (PCB KiCad v0.3 + Bruce)
    Dispositivo portátil estilo Cardputer para o firmware Bruce em ESP32-S3,
    soldável à mão (THT + DevKit encaixável).
    - Projeto KiCad: esquemático + PCB v0.3 (100x100 mm, 4x M3)
    - Gerbers JLCPCB, BOM e lista de compras com links
    - Mapa de pinos (GUIA.md) e logo CURUPIRA
    - README e .gitignore
    [bom.csv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]
2026-11-04 feat: identidade visual, modelo 3D do DevKit e renders
    - Serigrafia da frente: rótulos reposicionados junto de cada peça; nome
    removido da frente.
    - Verso: rosto do Curupira + "CURUPIRA" em Bungee (polígonos) + linha da
    versão, na faixa livre entre as fileiras do DevKit.
    - U1: modelo 3D do ESP32-S3-DevKitC-1 (3d/), alinhado aos pinos e elevado
    sobre 2x barras fêmea 1x22.
    - renders/: todas as vistas (fundo transparente) + gerar.sh para recriar.
    - arte/: rosto P&B e colorido com fundo transparente, fonte Bungee (OFL).
    - README com logo colorido e seção de renders; GUIA com as mudanças pós-v0.3.
    [ESP32-S3-DevKitC-1.step, cardputer-v0.kicad_pcb]
2026-11-04 refactor: renomeia o projeto KiCad para curupira-diy
    - cardputer-v0.kicad_* -> curupira-diy.kicad_* (referências internas do
    projeto atualizadas; numeração dos componentes preservada).
    - Carimbo do esquemático e da placa: "CURUPIRA DIY v0 - placa de estudo".
    - GUIA, README e renders/gerar.sh apontam para os novos nomes; renders
    regerados.
    [curupira-diy.kicad_pcb, curupira-diy.kicad_sch]
2026-11-04 feat: buzzer, arranjo em dois lados e modelos 3D dos módulos
    - Som: MAX98357A (J7, GPIO 3/45/46) trocado por buzzer passivo no GPIO3
    (R9 + Q2 BC337 + D4 1N4148); GPIO45/46 liberados.
    - Arranjo em dois lados dentro de 100x100 mm: frente com tela, botões,
    IR, buzzer e GPS; verso com DevKit (USB na borda), PN532, CC1101 e
    NRF24 (SMA na borda), microSD, CardKB e TP4056 (USB-C na borda).
    - J3 1x9 dividido em J3 (CC1101) e J9 (NRF24), conectores 2x4.
    - Ordem dos pinos de J2, J3 e J6 ajustada aos módulos encaixados.
    - Modelos 3D dos módulos em 3d/ (microSD com substituto visual).
    - Logo do verso reposicionado; serigrafia e zona ANTENA atualizadas.
    - GUIA com tabela do arranjo; README com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
    [CC1101-E07-M1101D-SMA.step, GPS-NEO-6M.step, NRF24L01-PA-LNA.step, PN532-V3.step, TFT-ST7789-2.0-GMT020-02.step, TP4056-USB-C.step, curupira-diy.kicad_pcb, curupira-diy.kicad_sch]
2026-11-04 feat: roteamento completo, planos de GND e logo na frente
    - Placa roteada com Freerouting 2.5.0 (71 ligações, 0 violações).
    - Planos de GND nas duas faces; zona ANTENA continua sem cobre.
    - Classes de rede: Default 0,25 mm; Power (+3V3, GND, VIN) 0,6 mm.
    - Largura mínima de trilha 0,15 mm (trechos de 0,187 mm entre ilhas THT).
    - Logo (rosto + CURUPIRA + versão) na frente, centralizado entre as
    fileiras de pinos do DevKit.
    - DRC: 0 ligações pendentes, paridade esquemático x placa zerada.
    [curupira-diy.kicad_pcb]
2026-11-04 chore: projeto autossuficiente (modelos 3D, biblioteca local e pinagem)
    - 3d/kicad/: cópia dos 17 modelos 3D padrão do KiCad usados na placa;
    a placa aponta para ${KIPRJMOD}/3d/... e abre completa sem a
    biblioteca 3D instalada. 3d/LEIA-ME.md lista a fonte de cada modelo.
    - lib/: símbolo e footprint do ESP32-S3-DevKitC (Espressif KiCad Library)
    registrados como PCM_Espressif em sym-lib-table/fp-lib-table; o
    footprint já inclui os modelos 3D alinhados. ERC agora sem avisos.
    - docs/pinagem.html: diagrama interativo da pinagem do ESP32.
    - .gitignore corrigido (comentários na mesma linha anulavam as regras);
    curupira-diy.kicad_prl deixa de ser versionado.
    [Buzzer_12x9.5RM7.6.step, C_Disc_D3.0mm_W1.6mm_P2.50mm.step, D_DO-35_SOD27_P7.62mm_Horizontal.step, D_DO-41_SOD81_P10.16mm_Horizontal.step, LED_D3.0mm.step, LED_D5.0mm.step, PinHeader_1x02_P2.54mm_Vertical.step, PinSocket_1x04_P2.54mm_Vertical.step]
2026-11-05 feat: remove buzzer, 2o emissor IR e re-layout com re-roteamento
    - remove buzzer (BZ1/Q2/R9/D4), liberando o GPIO3
    - adiciona 2o emissor IR (D5 + R10) em paralelo; emissores simetricos nos cantos de cima
    - reposiciona componentes e re-roteia a placa inteira (Freerouting)
    - GND: alivio termico + 78 vias de stitching, DRC 0 violacoes
    - regenera Gerbers (production/curupira-v0.4-gerbers-jlcpcb.zip)
    [curupira-diy-B_Adhesive.gbr, curupira-diy-B_Courtyard.gbr, curupira-diy-B_Cu.gbr, curupira-diy-B_Fab.gbr, curupira-diy-B_Mask.gbr, curupira-diy-B_Paste.gbr, curupira-diy-B_Silkscreen.gbr, curupira-diy-Edge_Cuts.gbr]
2026-11-05 docs: atualiza renders para o layout v0.4
2026-11-05 docs: atualiza README, BOM e lista de compras para v0.4
    - README: 2 emissores IR (D3/D5), link do Bruce (BruceDevices/firmware),
    descrição da pasta production/
    - BOM regenerado do esquemático (D3+D5, R2+R10; sem buzzer)
    - lista de compras: remove MAX98357A/alto-falante/J7, adiciona D5/R10,
    J3/J9 como soquetes 2x4 e novo plano de corte da barra fêmea
    - GUIA: nota histórica aponta a v0.3 para a tag v0.3.0
    - remove Gerbers, zip e renders antigos da v0.3 de production/
    [bom.csv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]
2026-11-05 docs: adiciona plano de teste na protoboard
    - docs/TESTE_PROTOBOARD.md: 12 etapas bloco a bloco (DevKit, botões,
    tela, SD, I2C, IR, CC1101, NRF24, SPI completo, energia, GPS, Bruce)
    com critérios de aprovação e tabela de resultados
    - alerta para conferir a pinagem do J3 (CC1101) contra o módulo real
    - README: link para o plano no Estado e na Estrutura
2026-11-05 docs: esclarece numeração do J3 (CC1101)
    - GUIA: tabela de pinagem passa a citar o pino do J3 (J3-6 CSN,
    J3-5 GDO0) junto com o pino do módulo, evitando ambiguidade
    - plano de teste: troca o alerta de J3 por conferência do módulo
    E07-M1101D, cujo espelhamento no J3 é intencional (face pra fora)
2026-11-05 fix: remove via sobre o furo do J9 e ajusta serigrafia (v0.4.1)
    - remove via de GND em (158.95, 91.95) que sobrepunha o furo do
    pino 1 do J9 (hole_to_hole 0,00 mm)
    - move o texto "PN532" (B.Silk) para baixo do J2, fora do pad 4
    - atribui ao pad 13 do U1 (GPIO3) a rede unconnected do esquemático
    - serigrafia da versão: v0.3 -> v0.4.1 (frente e verso)
    - Gerbers regenerados em production/gerbers-v0.4.1 + zip JLCPCB;
    remove os Gerbers v0.4 (preservados na tag v0.4.0)
    - renders regenerados; README e lista de compras apontam p/ v0.4.1
    - DRC: só os 2 avisos esperados de serigrafia do DevKit na borda
    [curupira-diy-B_Adhesive.gbr, curupira-diy-B_Courtyard.gbr, curupira-diy-B_Cu.gbl, curupira-diy-B_Fab.gbr, curupira-diy-B_Mask.gbs, curupira-diy-B_Paste.gbr, curupira-diy-B_Silkscreen.gbo, curupira-diy-Edge_Cuts.gm1]
2026-11-05 docs: adiciona manual interativo de teste na protoboard
    - docs/teste-protoboard.html: protoboard desenhada passo a passo
    (DevKit, botões, tela, SD, I2C, IR, CC1101, NRF24, SPI, bateria,
    GPS, Bruce), com ligações, o que esperar, sketches de teste,
    checklist e anotações salvos no navegador
    - links para o manual no README e no TESTE_PROTOBOARD.md
2026-11-05 docs: lista de compras com controle do que já foi comprado
    - coluna "Comprado" (⬜/✅) em todas as tabelas, já marcada
    - remove preços, links de anúncio e o plano de corte da barra fêmea
    - microSD: separa leitor (módulo) e cartão; GPS deixa de ser opcional
