acacio90/curupira-diy/(notices)

Notices in the files:
3d/kicad/C_Disc_D3.0mm_W1.6mm_P2.50mm.step:
Copyright (C) 2017, kicad StepUp
This program is free software: you can redistribute it and/or modify
it under the terms of the GNU General Public License as published by
the Free Software Foundation, either version 3 of the License, or
any later version.
itself might be covered by the GNU General Public License.
3d/kicad/PinHeader_1x02_P2.54mm_Vertical.step:
This work is licensed under the [Creative Commons CC-BY-SA 4.0 License](https://creativecommons.org/licenses/by-sa/4.0/legalcode),
with the following exception:
To the extent that the creation of electronic designs that use 'Licensed Material' can be considered to be 'Adapted Material',
You are free to use the library data in your own projects without the obligation to share your project files under this or any other license agreement.
3d/kicad/Buzzer_12x9.5RM7.6.step:
Copyright (C) 2018, kicad StepUp
3d/kicad/PinSocket_1x04_P2.54mm_Vertical.step:
Copyright (C) 2024, KiCAD
This work is licensed under the
[Creative Commons CC-BY-SA 4.0 License](https://creativecommons.org/licenses/by-sa/4.0/legalcode),
project files under this or any other license agreement. However, if you wish to distribute
